Sail128/mirte-pcb/mirte-master-v2/mirte-master-v2.kicad_pcb

## KiCad design mirte-master-v2/mirte-master-v2.kicad_pcb (2024-10-31)

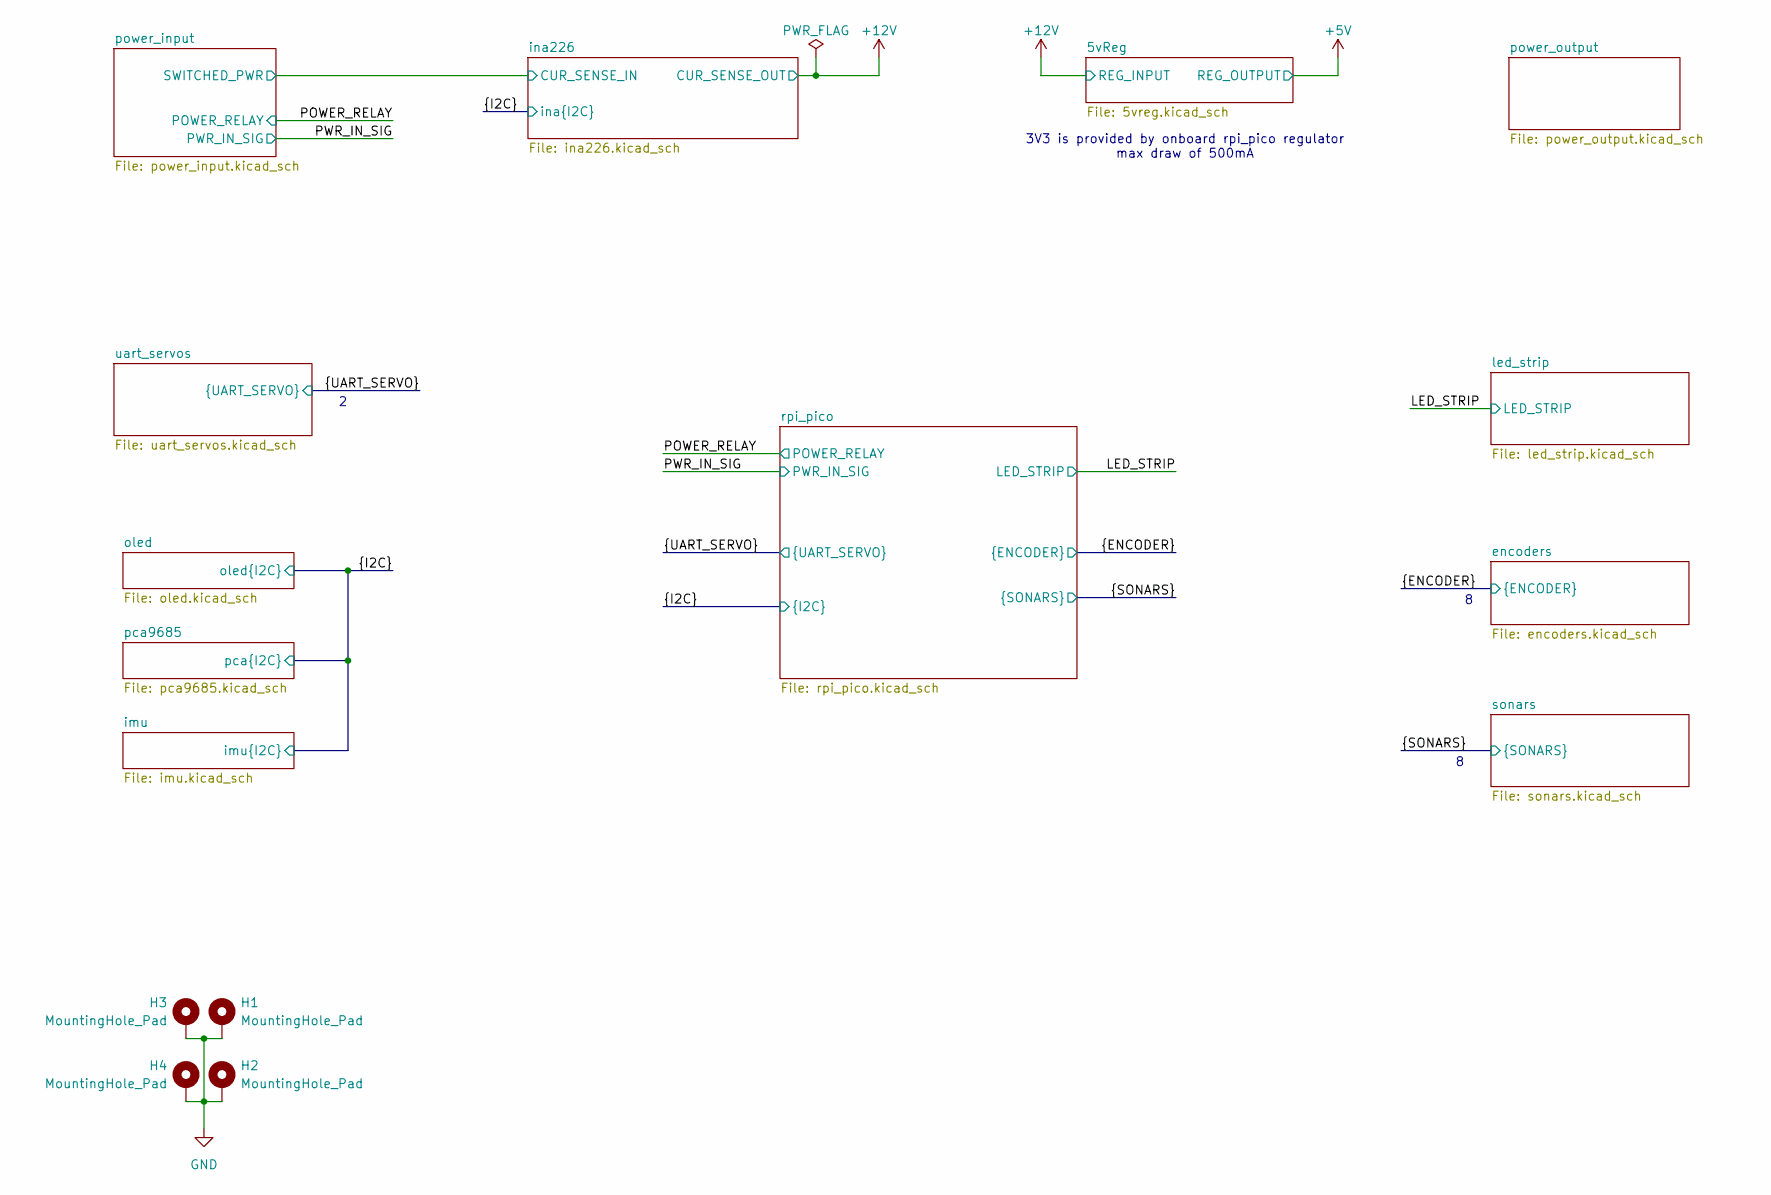
[picture p1: schematic mirte-master-v2.kicad_sch, ${PROJECTNAME}]

Parts:
H1, H2, H3, H4: MountingHole_Pad; MountingHole_3.2mm_M3_Pad

Connections:
GND: H1.1, H2.1, H3.1, H4.1; also elsewhere on the board

Notes on the sheet:
3V3 is provided by onboard rpi_pico regulator max draw of 500mA

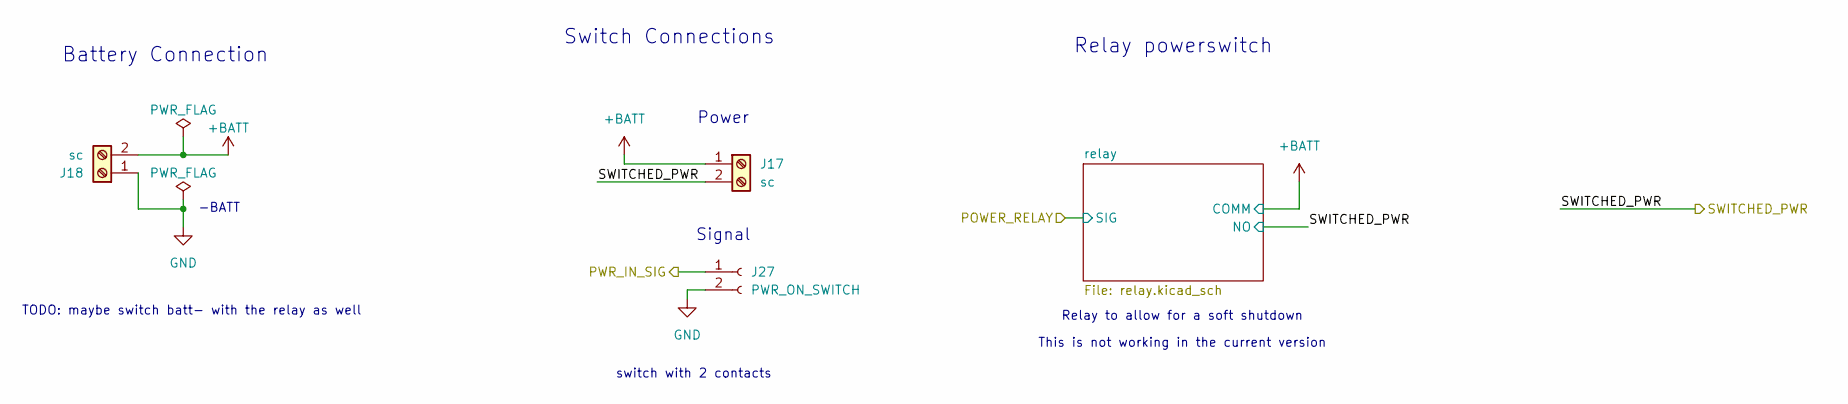
[picture p2: schematic power_input.kicad_sch, ${PROJECTNAME}]

Parts:
J17, J18: sc; CONN-TH_XY126V-5.0-2P; LCSC C557646
J27: PWR_ON_SWITCH; JST_XH_B2B-XH-A_1x02_P2.50mm_Vertical; LCSC C158012

Connections:
+BATT: J17.1, J18.2; also elsewhere on the board
/PWR_IN_SIG: J27.1; also elsewhere on the board
/power_input/SWITCHED_PWR: J17.2; also elsewhere on the board
GND: J18.1, J27.2; also elsewhere on the board

Notes on the sheet:
TODO: maybe switch batt- with the relay as well
This is not working in the current version
Battery Connection
Signal
-BATT
Power
Relay to allow for a soft shutdown
Relay powerswitch
Switch Connections
switch with 2 contacts

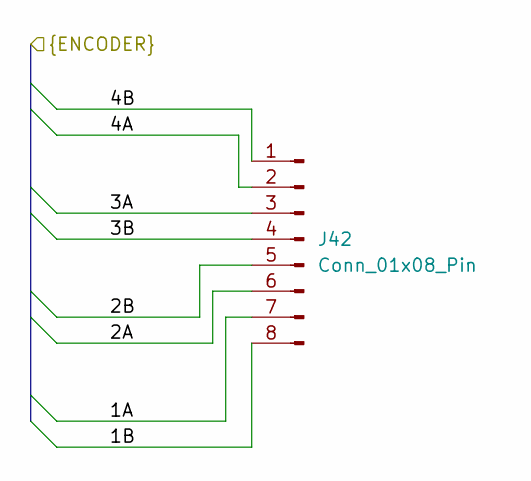
[picture p3: schematic encoders.kicad_sch, ${PROJECTNAME}]

Parts:
J42: Conn_01x08_Pin; JST_XH_B8B-XH-A_1x08_P2.50mm_Vertical; LCSC C157972

Connections:
/1A: J42.7; also elsewhere on the board
/1B: J42.8; also elsewhere on the board
/2A: J42.6; also elsewhere on the board
/2B: J42.5; also elsewhere on the board
/3A: J42.3; also elsewhere on the board
/3B: J42.4; also elsewhere on the board
/4A: J42.2; also elsewhere on the board
/4B: J42.1; also elsewhere on the board

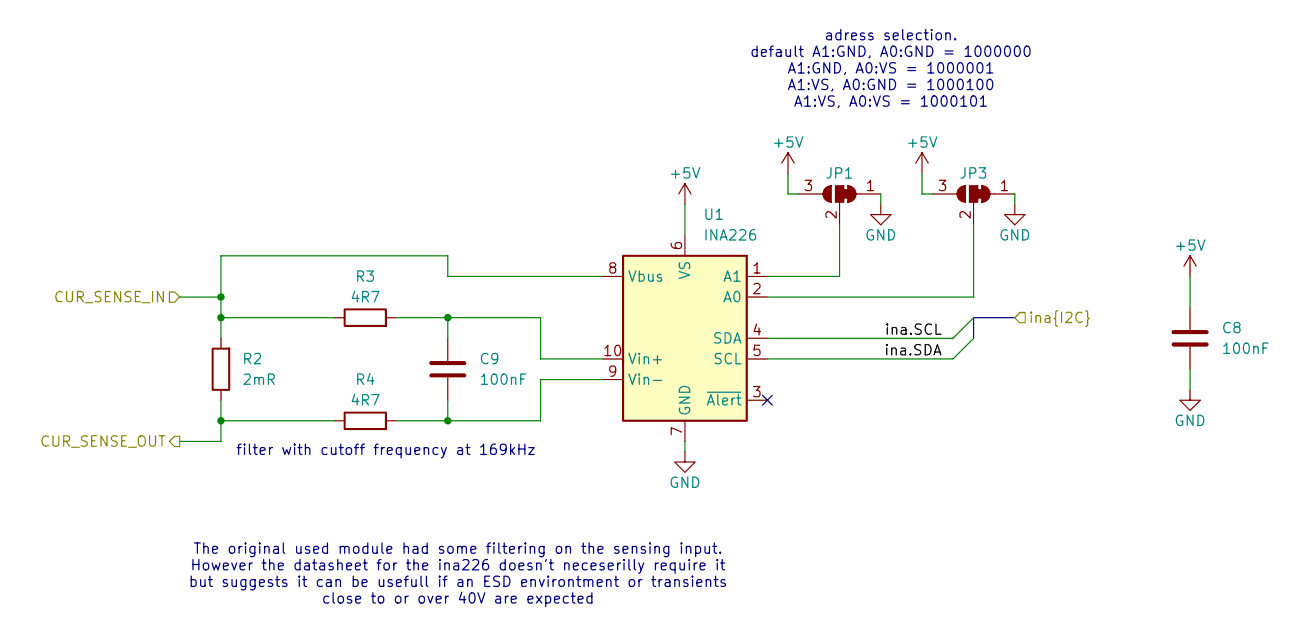
[picture p4: schematic ina226.kicad_sch, ${PROJECTNAME}]

Parts:
C8, C9: 100nF; C_0805_2012Metric; LCSC C49678
JP1, JP3: SolderJumper_3_Bridged12; SolderJumper-3_P1.3mm_Bridged12_RoundedPad1.0x1.5mm
R2: 2mR; R_2512_6332Metric; LCSC C160590
R3, R4: 4R7; R_0805_2012Metric; LCSC C137513
U1: INA226; VSSOP-10_3x3mm_P0.5mm; LCSC C49851

Connections:
+5V: C8.1, JP1.3 (B), JP3.3 (B), U1.6 (VS); also elsewhere on the board
+12V: R2.1, R4.1; also elsewhere on the board
/SCL: U1.4 (SDA); also elsewhere on the board
/SDA: U1.5 (SCL); also elsewhere on the board
/power_input/SWITCHED_PWR: R2.2, R3.1, U1.8 (Vbus); also elsewhere on the board
GND: C8.2, JP1.1 (A), JP3.1 (A), U1.7 (GND); also elsewhere on the board
unnamed: JP1.2 (C), U1.1 (A1)
unnamed: JP3.2 (C), U1.2 (A0)
unnamed: C9.1, R3.2, U1.10 (Vin+)
unnamed: C9.2, R4.2, U1.9 (Vin-)

Notes on the sheet:
filter with cutoff frequency at 169kHz
The original used module had some filtering on the sensing input. However the datasheet for the ina226 doesn't neceserilly require it but suggests it can be usefull if an ESD environtment or transients close to or over 40V are expected
adress selection. default A1:GND, A0:GND = 1000000 A1:GND, A0:VS = 1000001 A1:VS, A0:GND = 1000100 A1:VS, A0:VS = 1000101

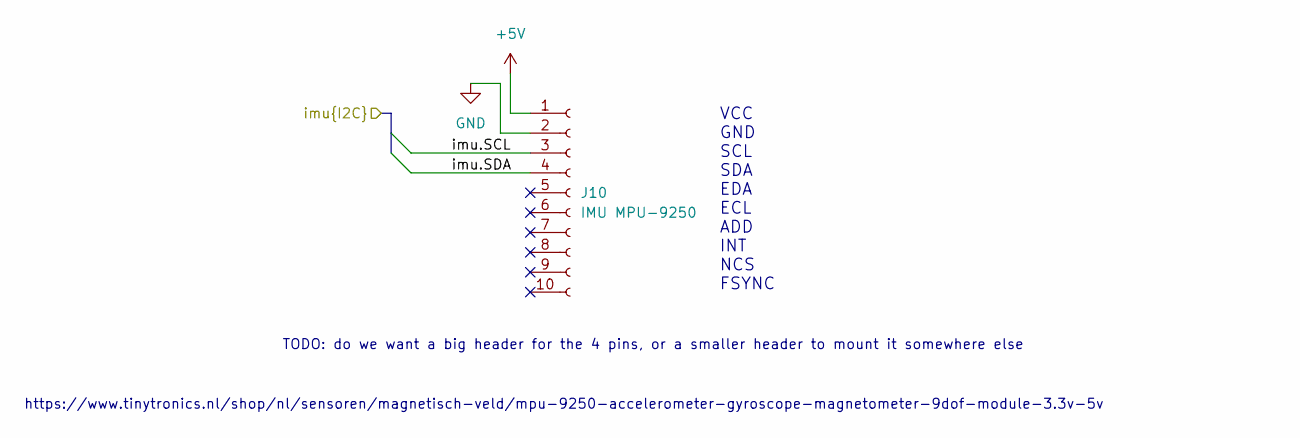
[picture p5: schematic imu.kicad_sch, ${PROJECTNAME}]

Parts:
J10: IMU MPU-9250; MPU9250; LCSC C2897373

Connections:
+5V: J10.1; also elsewhere on the board
/SCL: J10.3; also elsewhere on the board
/SDA: J10.4; also elsewhere on the board
GND: J10.2; also elsewhere on the board

Notes on the sheet:
https://www.tinytronics.nl/shop/nl/sensoren/magnetisch-veld/mpu-9250-accelerometer-gyroscope-magnetometer-9dof-module-3.3v-5v
TODO: do we want a big header for the 4 pins, or a smaller header to mount it somewhere else
VCC GND SCL SDA EDA ECL ADD INT NCS FSYNC

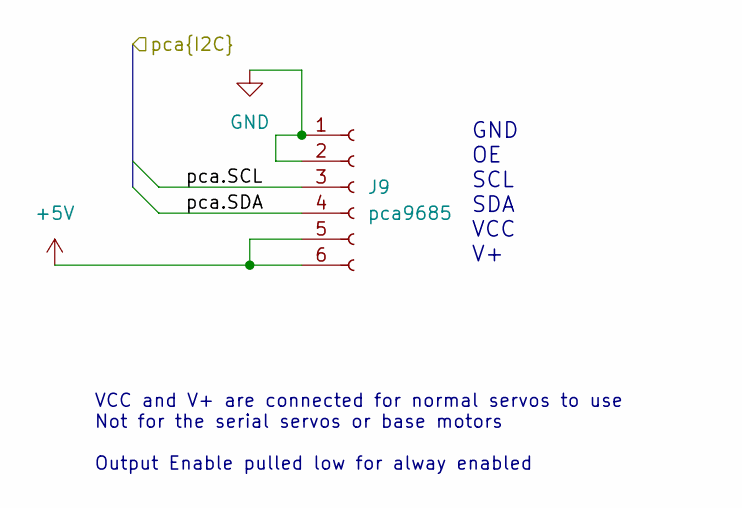
[picture p6: schematic pca9685.kicad_sch, ${PROJECTNAME}]

Parts:
J9: pca9685; PinHeader_1x06_P2.54mm_Vertical; LCSC C37208

Connections:
+5V: J9.5, J9.6; also elsewhere on the board
/SCL: J9.3; also elsewhere on the board
/SDA: J9.4; also elsewhere on the board
GND: J9.1, J9.2; also elsewhere on the board

Notes on the sheet:
GND OE SCL SDA VCC V+
VCC and V+ are connected for normal servos to use Not for the serial servos or base motors Output Enable pulled low for alway enabled

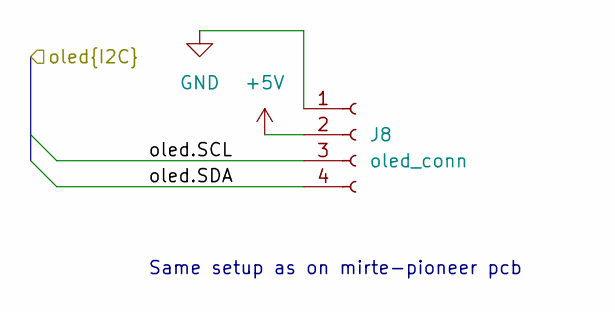
[picture p7: schematic oled.kicad_sch, ${PROJECTNAME}]

Parts:
J8: oled_conn; JST_XH_B4B-XH-A_1x04_P2.50mm_Vertical; LCSC C144395

Connections:
+5V: J8.2; also elsewhere on the board
/SCL: J8.3; also elsewhere on the board
/SDA: J8.4; also elsewhere on the board
GND: J8.1; also elsewhere on the board

Notes on the sheet:
Same setup as on mirte-pioneer pcb

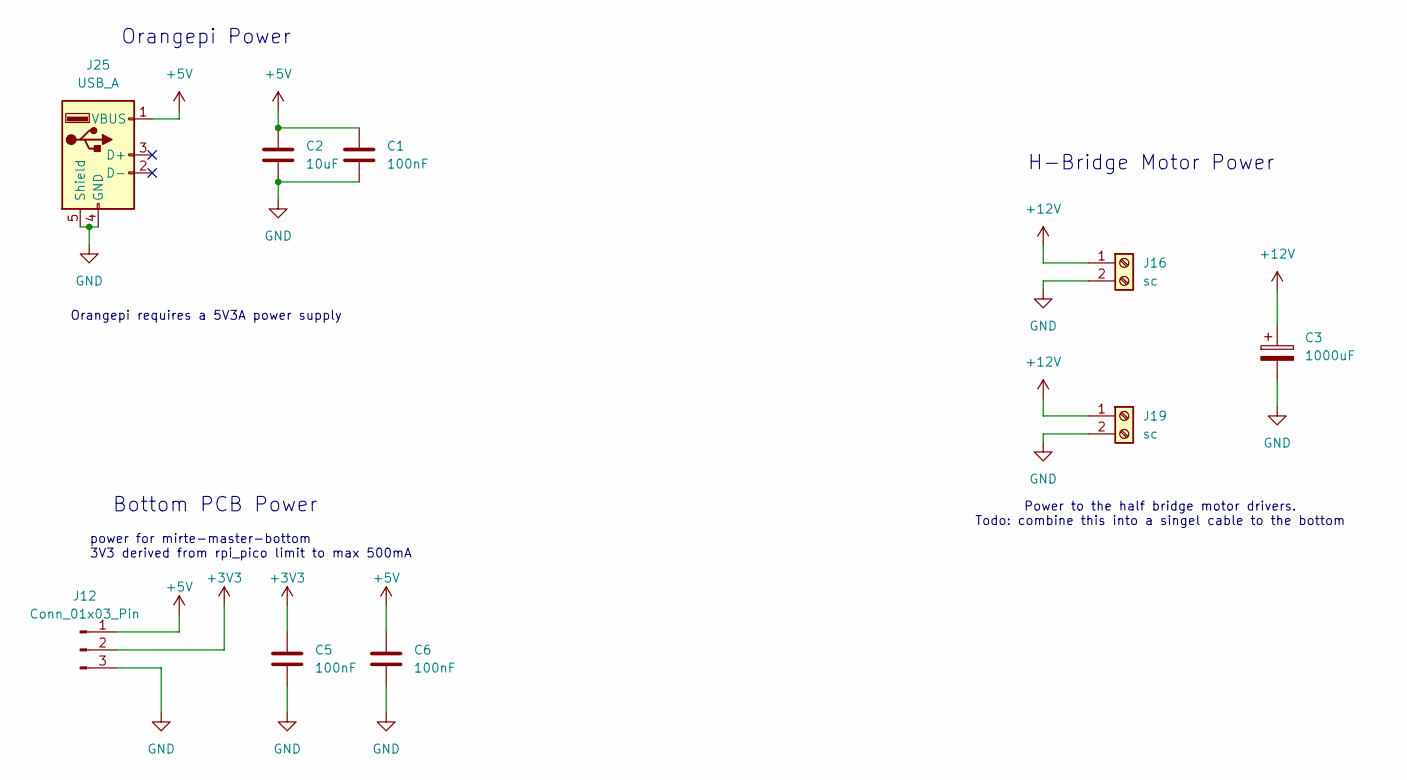
[picture p8: schematic power_output.kicad_sch, ${PROJECTNAME}]

Parts:
C1, C5, C6: 100nF; C_0805_2012Metric; LCSC C49678
C2: 10uF; C_0805_2012Metric; LCSC C15850
C3: 1000uF; CP_Radial_D10.0mm_P3.50mm; LCSC C110138
J12: Conn_01x03_Pin; JST_XH_B3B-XH-A_1x03_P2.50mm_Vertical; LCSC C144394
J16, J19: sc; CONN-TH_XY126V-5.0-2P; LCSC C557646
J25: USB_A; USB_A_Molex_67643_Horizontal; LCSC C456018

Connections:
+3V3: C5.1, J12.2; also elsewhere on the board
+5V: C1.1, C2.1, C6.1, J12.1, J25.1 (VBUS); also elsewhere on the board
+12V: C3.1, J16.1, J19.1; also elsewhere on the board
GND: C1.2, C2.2, C3.2, C5.2, C6.2, J12.3, J16.2, J19.2, J25.4 (GND), J25.5 (Shield); also elsewhere on the board

Notes on the sheet:
Orangepi Power
H-Bridge Motor Power
power for mirte-master-bottom 3V3 derived from rpi_pico limit to max 500mA
Orangepi requires a 5V3A power supply
Bottom PCB Power
Power to the half bridge motor drivers. Todo: combine this into a singel cable to the bottom

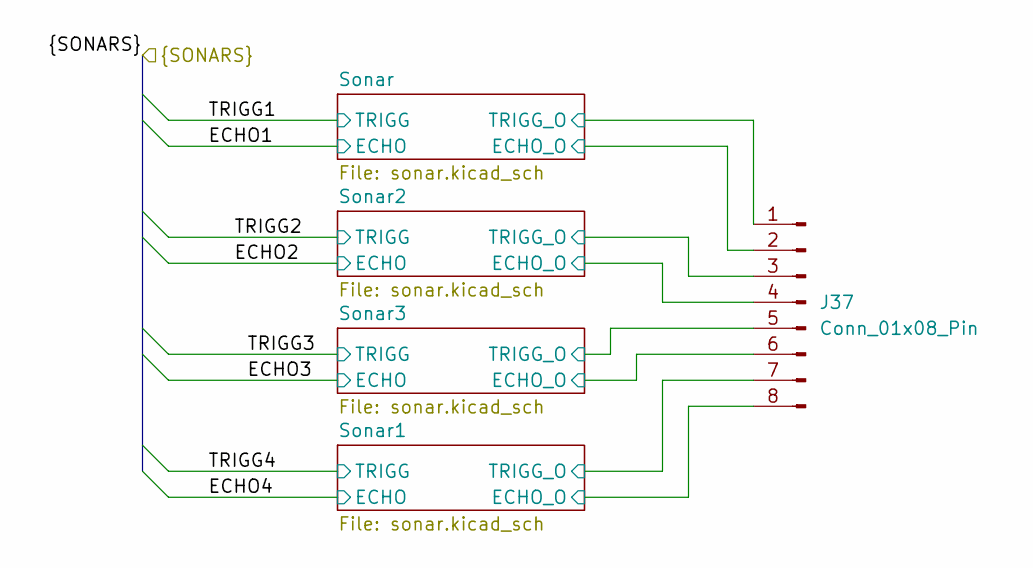
[picture p9: schematic sonars.kicad_sch, ${PROJECTNAME}]

Parts:
J37: Conn_01x08_Pin; JST_XH_B8B-XH-A_1x08_P2.50mm_Vertical; LCSC C157972

Connections:
/ECHO1: J37.2; also elsewhere on the board
/ECHO2: J37.4; also elsewhere on the board
/ECHO3: J37.6; also elsewhere on the board
/ECHO4: J37.8; also elsewhere on the board
/TRIGG1: J37.1; also elsewhere on the board
/TRIGG2: J37.3; also elsewhere on the board
/TRIGG3: J37.5; also elsewhere on the board
/TRIGG4: J37.7; also elsewhere on the board

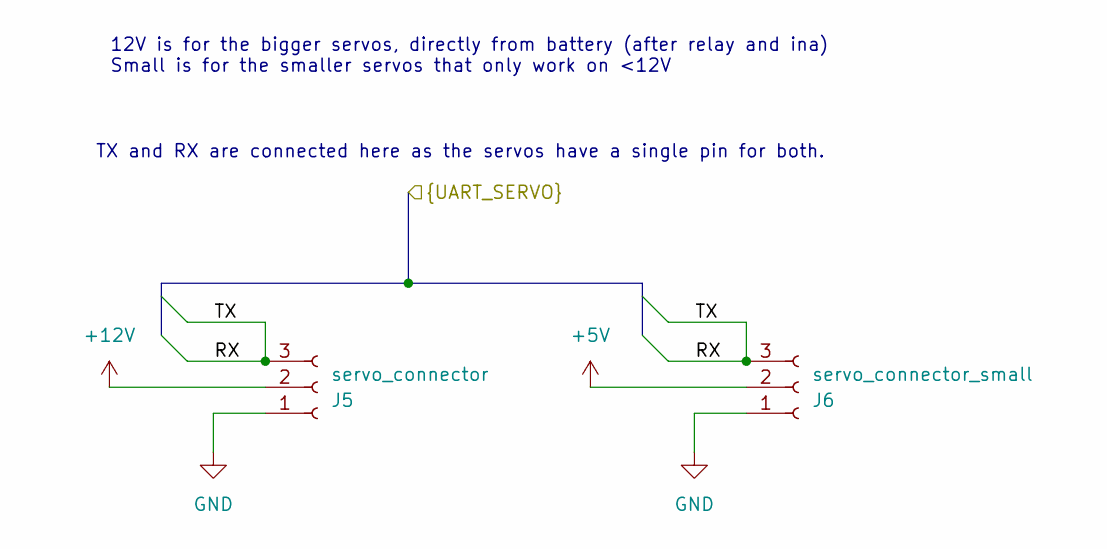
[picture p10: schematic uart_servos.kicad_sch, ${PROJECTNAME}]

Parts:
J5: servo_connector; JST_PH_B3B-PH-K_1x03_P2.00mm_Vertical; LCSC C131339
J6: servo_connector_small; JST_PH_B3B-PH-K_1x03_P2.00mm_Vertical; LCSC C131339

Connections:
+5V: J6.2; also elsewhere on the board
+12V: J5.2; also elsewhere on the board
/RX: J5.3, J6.3; also elsewhere on the board
GND: J5.1, J6.1; also elsewhere on the board

Notes on the sheet:
TX and RX are connected here as the servos have a single pin for both.
12V is for the bigger servos, directly from battery (after relay and ina) Small is for the smaller servos that only work on <12V

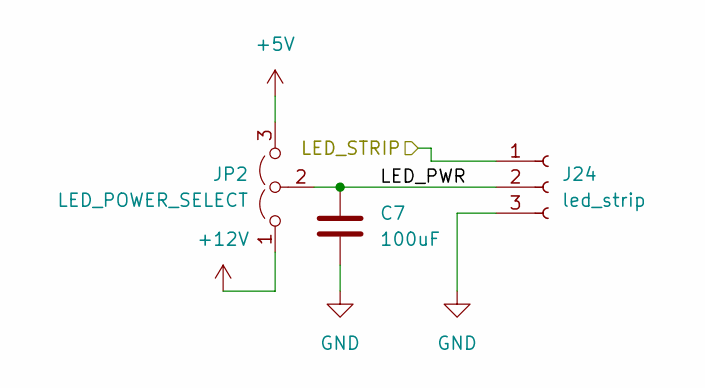
[picture p11: schematic led_strip.kicad_sch, ${PROJECTNAME}]

Parts:
C7: 100uF; C_0805_2012Metric; LCSC C15850
J24: led_strip; JST_XH_B3B-XH-A_1x03_P2.50mm_Vertical; LCSC C144394
JP2: LED_POWER_SELECT; SolderJumper-3_P2.0mm_Open_TrianglePad1.0x1.5mm

Connections:
+5V: JP2.3 (B); also elsewhere on the board
+12V: JP2.1 (A); also elsewhere on the board
/LED_STRIP: J24.1; also elsewhere on the board
/led_strip/LED_PWR: C7.1, J24.2, JP2.2 (C)
GND: C7.2, J24.3; also elsewhere on the board

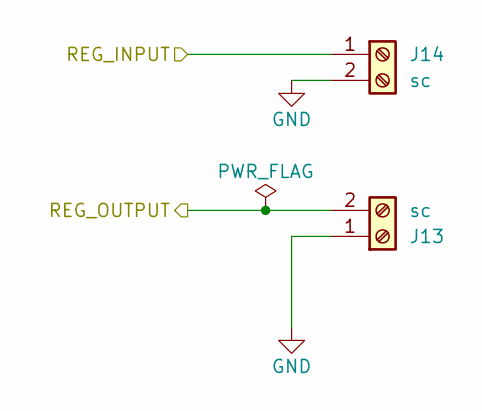
[picture p12: schematic 5vreg.kicad_sch, ${PROJECTNAME}]

Parts:
J13, J14: sc; CONN-TH_XY126V-5.0-2P; LCSC C557646

Connections:
+5V: J13.2; also elsewhere on the board
+12V: J14.1; also elsewhere on the board
GND: J13.1, J14.2; also elsewhere on the board

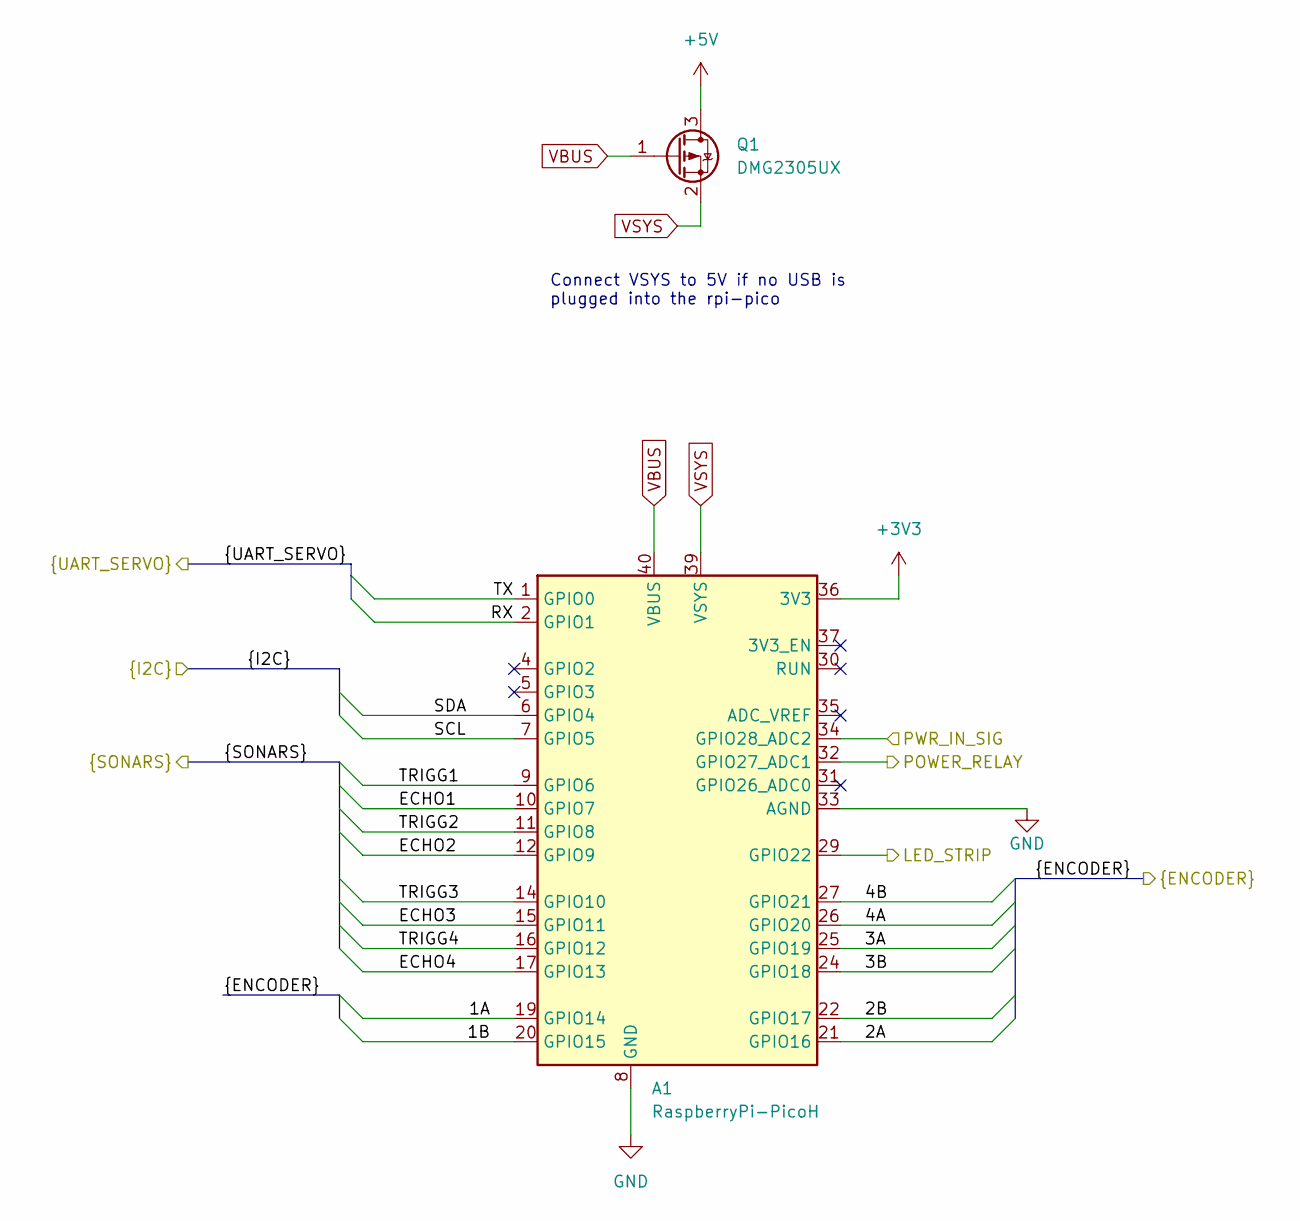
[picture p13: schematic rpi_pico.kicad_sch, ${PROJECTNAME}]

Parts:
A1: RaspberryPi-PicoH; Raspberry_Pi_Pico_double
Q1: DMG2305UX; SOT-23; LCSC C144153

Connections:
+3V3: A1.36 (3V3); also elsewhere on the board
+5V: Q1.3 (D); also elsewhere on the board
/1A: A1.19 (GPIO14); also elsewhere on the board
/1B: A1.20 (GPIO15); also elsewhere on the board
/2A: A1.21 (GPIO16); also elsewhere on the board
/2B: A1.22 (GPIO17); also elsewhere on the board
/3A: A1.25 (GPIO19); also elsewhere on the board
/3B: A1.24 (GPIO18); also elsewhere on the board
/4A: A1.26 (GPIO20); also elsewhere on the board
/4B: A1.27 (GPIO21); also elsewhere on the board
/ECHO1: A1.10 (GPIO7); also elsewhere on the board
/ECHO2: A1.12 (GPIO9); also elsewhere on the board
/ECHO3: A1.15 (GPIO11); also elsewhere on the board
/ECHO4: A1.17 (GPIO13); also elsewhere on the board
/LED_STRIP: A1.29 (GPIO22); also elsewhere on the board
/POWER_RELAY: A1.32 (GPIO27_ADC1); also elsewhere on the board
/PWR_IN_SIG: A1.34 (GPIO28_ADC2); also elsewhere on the board
/RX: A1.1 (GPIO0), A1.2 (GPIO1); also elsewhere on the board
/SCL: A1.7 (GPIO5); also elsewhere on the board
/SDA: A1.6 (GPIO4); also elsewhere on the board
/TRIGG1: A1.9 (GPIO6); also elsewhere on the board
/TRIGG2: A1.11 (GPIO8); also elsewhere on the board
/TRIGG3: A1.14 (GPIO10); also elsewhere on the board
/TRIGG4: A1.16 (GPIO12); also elsewhere on the board
GND: A1.3 (GND), A1.8 (GND), A1.13 (GND), A1.18 (GND), A1.23 (GND), A1.28 (GND), A1.33 (AGND), A1.38 (GND); also elsewhere on the board
VBUS: A1.40 (VBUS), Q1.1 (G)
VSYS: A1.39 (VSYS), Q1.2 (S)

Notes on the sheet:
Connect VSYS to 5V if no USB is plugged into the rpi-pico

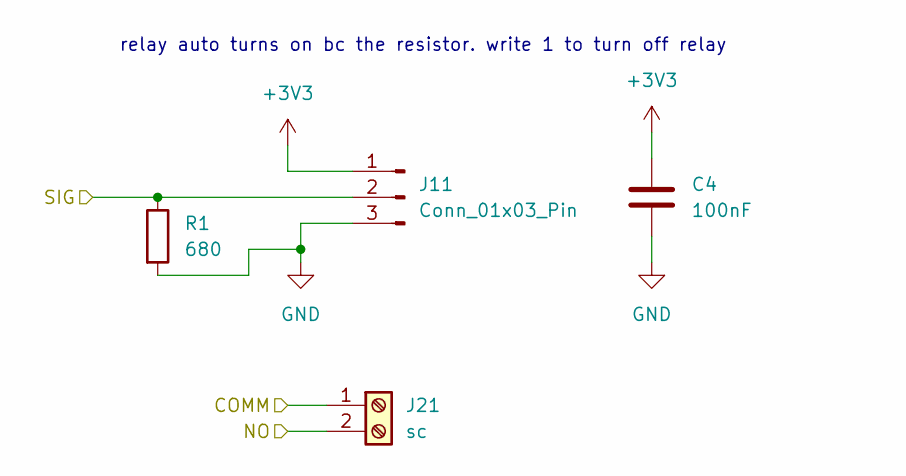
[picture p14: schematic relay.kicad_sch, ${PROJECTNAME}]

Parts:
C4: 100nF; C_0805_2012Metric; LCSC C49678
J11: Conn_01x03_Pin; JST_XH_B3B-XH-A_1x03_P2.50mm_Vertical; LCSC C144394
J21: sc; CONN-TH_XY126V-5.0-2P; LCSC C557646
R1: 680; R_0805_2012Metric; LCSC C17798

Connections:
+3V3: C4.1, J11.1; also elsewhere on the board
+BATT: J21.1; also elsewhere on the board
/POWER_RELAY: J11.2, R1.1; also elsewhere on the board
/power_input/SWITCHED_PWR: J21.2; also elsewhere on the board
GND: C4.2, J11.3, R1.2; also elsewhere on the board

Notes on the sheet:
relay auto turns on bc the resistor. write 1 to turn off relay

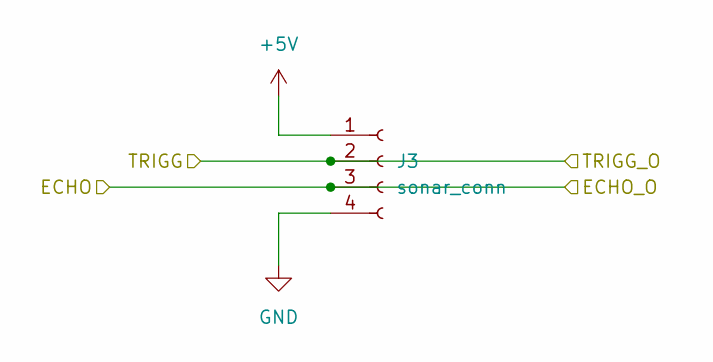
[picture p15: schematic sonar.kicad_sch, ${PROJECTNAME}]

Parts:
J3: sonar_conn; JST_XH_B4B-XH-A_1x04_P2.50mm_Vertical; LCSC C144395

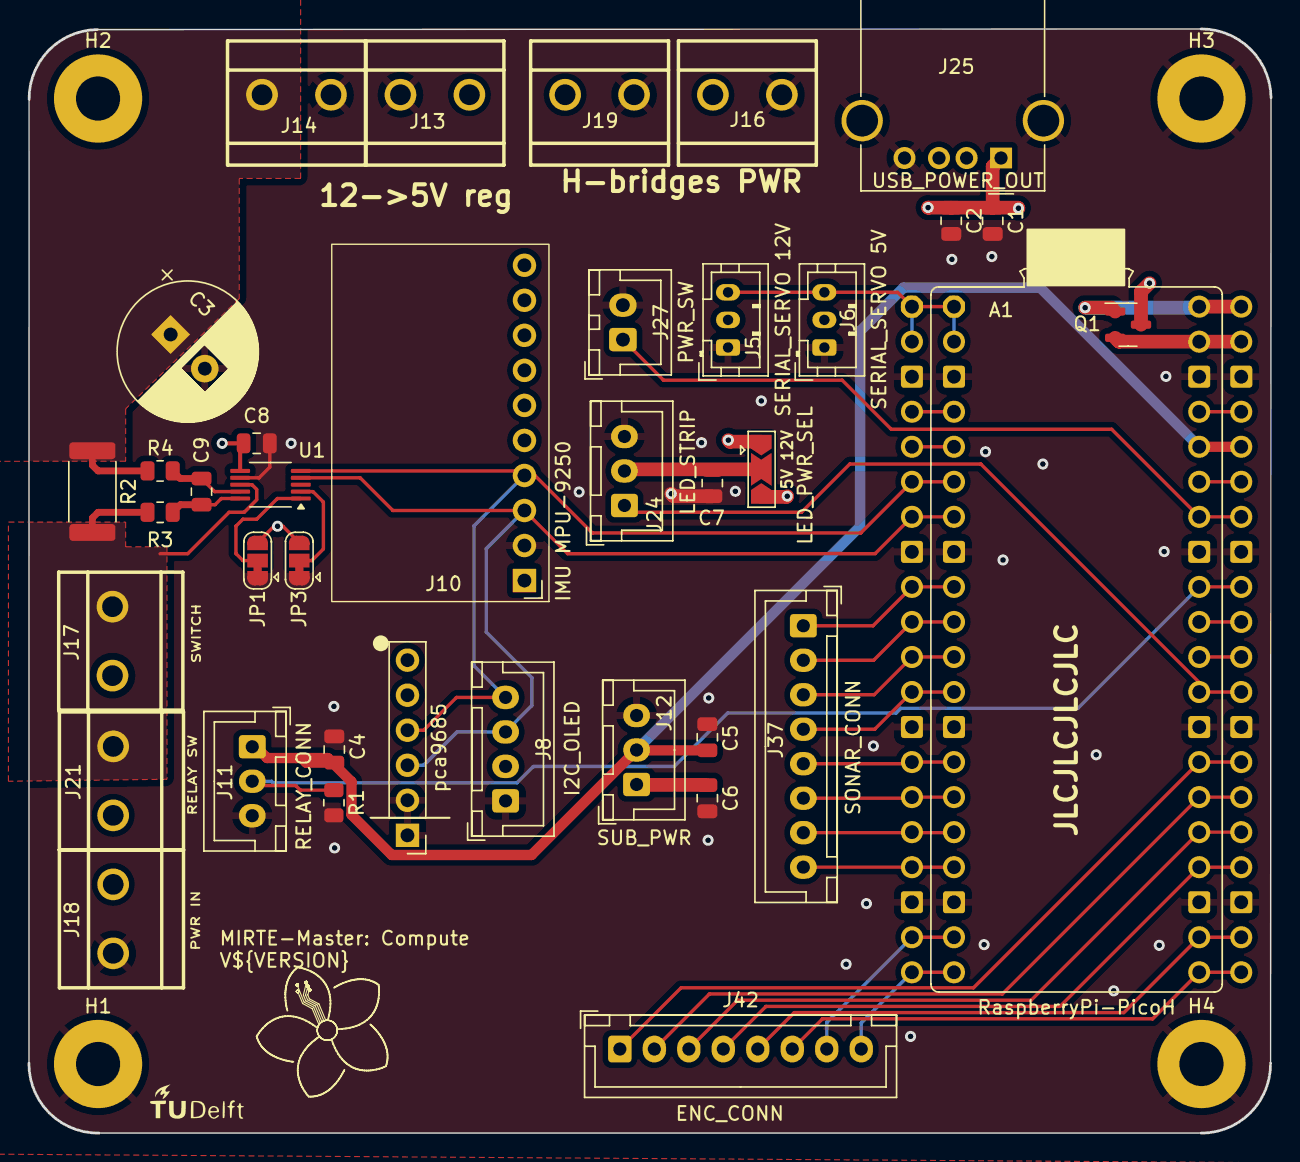
[picture p16: board mirte-master-v2.kicad_pcb from above]

Board: 4 copper layers, 90.1 x 80.1 mm, 43 parts (0 on the bottom side), 35 nets.

Other parts of the board:
G1: LOGO; tudelft_logo_10mm
