Sail128/mirte-pcb/(commit log)

2024-10-29 integrated the ina226 in the schematic
    [5vreg.kicad_sch, battery.kicad_sch, encoders.kicad_sch, hbridge_power.kicad_sch, i2c.kicad_sch, imu.kicad_sch, ina226.kicad_sch, led_strip.kicad_sch]
2024-10-31 integrated the ina226 in the pcb layout
    [imu.kicad_sch, ina226.kicad_sch, mirte-master-v2.kicad_pcb, oled.kicad_sch, pca9685.kicad_sch]
